NIAGroup/2020_Arduino_Pi_IOT_Project/README.md

# 2020_Arduino_Pi_IOT_Project 

This project utilizes a Flask webapp hosted on a Raspberry PI to control a cluster of Arduinos via bluetooth balancing a ping-pong ball on a flat beam. Each Arduino has a Pulse Width Modulation (PWM) stepper motor which is used to adjust the respective connected beams. The user enters values for the starting angle, proportion (kp), integral (ki), and derivative (kd) which are used in a PID control algorithm that dictates the behavior of the motors when attempting to place the ping-pong ball at the center of the beam.   



## Required Hardware

* Arduino & Supplies [LINK](https://www.amazon.com/ELEGOO-Project-Tutorial-Controller-Projects/dp/B01D8KOZF4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):  
    * Arduino Uno [alternate(s): arduino nano] 
    * Ultrasonic Sensor [alternate(s): IR Range Finder]
    * Stepper Motor & Driver
    * Jumper Wires (male-to-female & female-to-female)
* Raspberry Pi:
    * Pi 3 B+ & Power Supply [LINK](https://www.amazon.com/CanaKit-Raspberry-Power-Supply-Listed/dp/B07BC6WH7V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) [alternate(s): Pi 4, Pi Zero W]
    * 32GB Micro SD Card [LINK](https://www.amazon.com/SanDisk-Ultra-microSDXC-Memory-Adapter/dp/B073JWXGNT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) (16GB may be enough, but for future scaling up 32GB or greater would be best)
* Raspberry Pi Camera [LINK](https://www.amazon.com/Arducam-Raspberry-Camera-Module-Megapixel/dp/B083BHJZ16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)
* Ping Pong Ball [LINK](https://www.amazon.com/meizhouer-Colored-Entertainment-Tennis-Advertising/dp/B07JNCVVMF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)
* HC-05 Bluetooth Module [LINK](https://www.amazon.com/Wireless-Bluetooth-Transceiver-Module-Arduino/dp/B07T7ZZ3S5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)
* The Balance Beam 
>NOTE:: The balance beam will have to be hand crafted for now. When a tested design has been found/made it can be included in the list.  

## Prior Knowledge Needed/Googled

* Basic linux commands (i.e. cd, ls, mkdir, etc)
* Basic C/C++ understanding for arduino
* Basic circuit wiring understanding
* Intermediate Python 
* Basic HTML

## Expected Gained Knowledge  

* PWM - Pulse Width Modulation for Stepper Motor Control [EXPLAINED](https://www.youtube.com/watch?v=avrdDZD7qEQ)
* Bluetooth communication [ARDUINO & HC-05](https://www.youtube.com/watch?v=OhnxU8xALtg) [Raspberry PI](https://www.youtube.com/watch?v=F5-dV6ULeg8)
* Web Server Website/WebApp setup using apache2 [TUTORIAL](https://www.youtube.com/watch?v=dmBqzq3M5jQ)
* Front-End & Back-End Development
* PID - Proportional-Integral-Derivative Controller [EXPLAINED](https://www.youtube.com/watch?v=g7apd9a7Jxs)
