NIAGroup/2020_Arduino_Pi_IOT_Project/PID_controller_WebUI_roughdraft_00.PNG

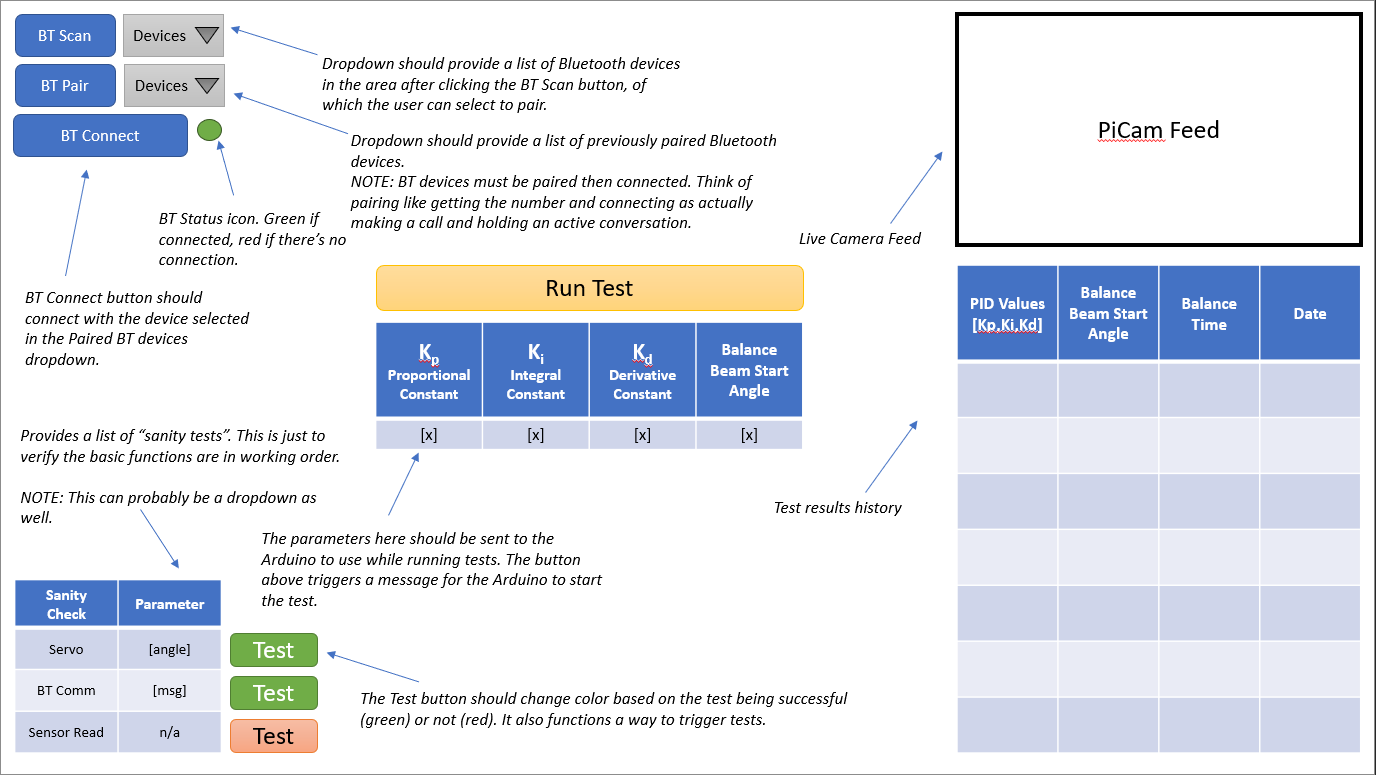
PID_controller_WebUI_roughdraft_00.PNG
