NIAGroup/2020_Arduino_Pi_IOT_Project/arduino_pid_controller/img/Servo_Wiring_Diagram.PNG

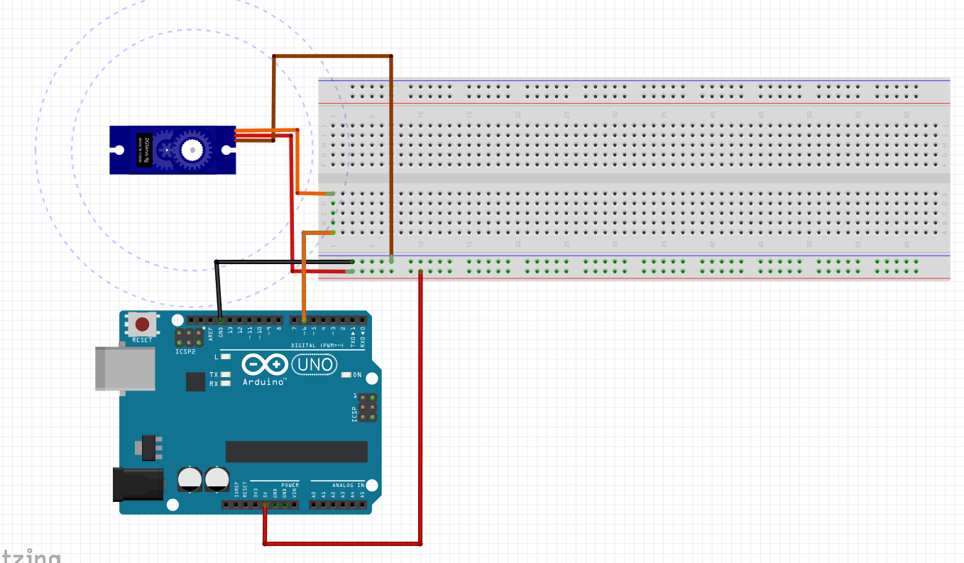
arduino_pid_controller/img/Servo_Wiring_Diagram.PNG
