NIAGroup/2020_Arduino_Pi_IOT_Project/arduino_pid_controller/img/UltrasonicSensor_Wiring_Diagram.PNG

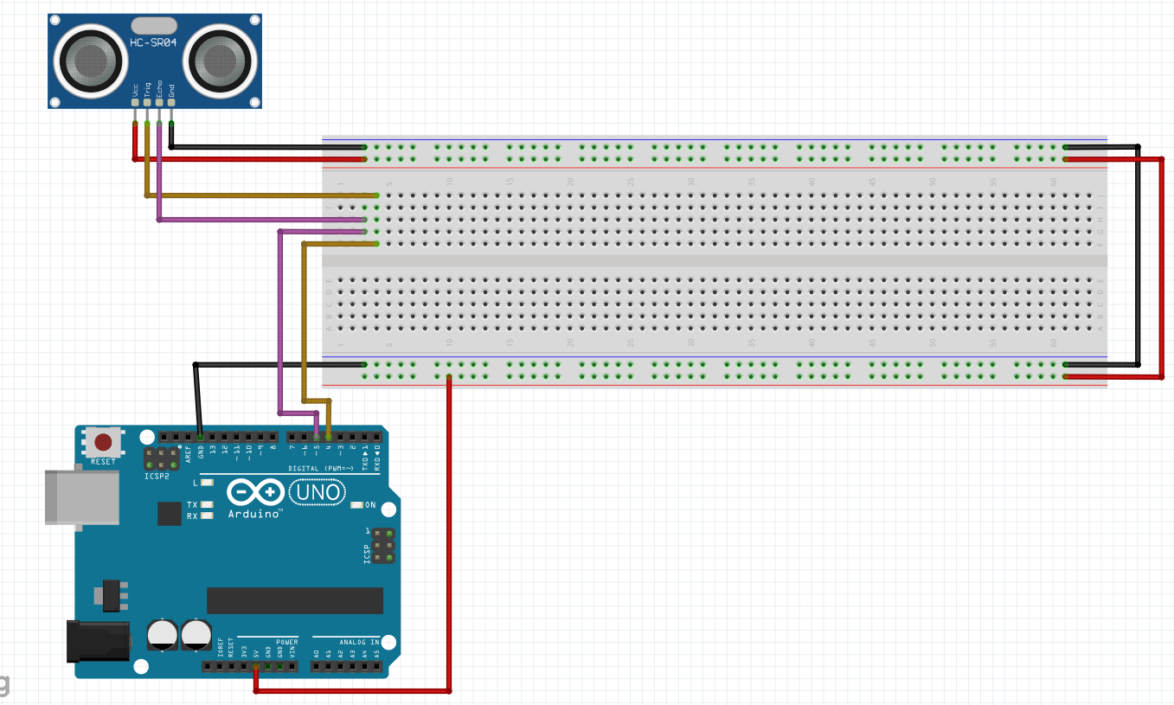
arduino_pid_controller/img/UltrasonicSensor_Wiring_Diagram.PNG
