NIAGroup/2020_Arduino_Pi_IOT_Project/arduino_pid_controller/code/btCommunication/BT_Communication_Standard.cpp

#include "BT_Communication_Standard.h"


BTComm_Standard::BTComm_Standard(){
 // default code
} 

FullBtMsg BTComm_Standard::Process_Request(byte pi_request[], byte length){
  FullBtMsg request;
  for(byte i = 0; i< length;i++){
   request.full_msg[i].full_byte = pi_request[i]; 
  }
  return request;
}

boolean BTComm_Standard::isSanityCheck(byte command_byte){
  byte upper_nibble = command_byte & 0b10000000;
  upper_nibble = upper_nibble >> 7;
  byte return_bit = 0;
  if (upper_nibble == 0){
    return_bit = false;
  }
  else{
    return_bit = true;
  }
  return return_bit;
}
