NIAGroup/2020_Arduino_Pi_IOT_Project/(commit log)

2020-07-29 Create ultrasonicSensor_example.ino
    Beginner's Example for sensor reading & PWM writing
2020-08-01 Create test_btScanForDevices.py
    added test to scan for bluetooth devices, both classic & ble devices.
    requires:
    python library - pybluez
    python library - gattlib
2020-08-05 Add files via upload
    added new wiring diagram examples for the HC-05 Bt Module & the Micro Servo
2020-08-05 Update ultrasonicSensor_example.ino
    editing pin assignment to make integration easier to follow.
2020-08-10 corrected navbar link error.
    [btCommunication_example.ino]
2020-08-31 Adding initial work to create a bluetooth device container for back-end work
2020-09-04 Message structures and device container classes constructed
2020-09-05 BT Ble device class 60% done and device list 70% done.
2020-09-08 new arduino test code and bt comm changes for testing [WIP]
2020-09-09 get_device api for obtaining a device by name.
2020-09-21 Added timer functions to original file
2020-09-23 import error fixed in app.py and devices.py. Additionally, displaying the new html code as the frontend.
2020-09-26 added sanity test for servo messages
2020-10-05 pairing script for non-ble devices
2020-10-06 bluetooth ble & non-ble send functions working and being received by the arduino successfully.
2020-10-06 send & receive working for ble & non-ble for both arduino & raspberry pi.
2020-10-06 fixed cached/old response error.
    [btCommunication.ino]
2020-10-11 Adding the ability to return a scanned device list name to a reactive list
2020-10-19 Initial back-end and js work for identifying selected devices and doing POST requests
2020-10-22 Cleaned up connection code with boarder color changes and back-end cleanup
2020-11-02 Adding read command for ble device
2020-11-16 Adding regular bluetooth device object
2020-11-24 minor tweaks for handling printing message payloads
2020-11-25 adding self._dev in ble device initalizer
2020-11-25 adjusted camera settings
2020-11-25 flipped camera view
2020-11-28 Adding pytests framework
2020-12-08 pulled to match branch and update PID controller example.
2020-12-09 PID controller function is working for (P) for the PID. Still testing
2020-12-09 corrected PID_D equation and testing w/ PID_P & PID_D values works
    [PIDcontroller_example.ino]
2020-12-28 Adding more unit testing for device class.
2021-01-04 Adding disconnect API in device classes and cleaning up app.py
2021-01-05 servo pin changed from pin 6 -> pin 5 & BLE enabled.
2021-01-05 added test condition for all 8 zero bytes as an option for both nonBle and Ble devices.
2021-01-06 sharpIR sensor example added as a reference. This uses the sharpIR library.
2021-01-06 updated sharpIR sensor instantiation to match the specific library version.
2021-01-08 adjusted example for basic sensor reading test.
2021-01-08 added functionality to eventually calculate upper and lower limits for the PID output.
2021-01-08 working PID controller example code with latest setup. Ready for testing.
2021-01-08 communication test code servo sanity check servo writing commented out. New ranges need to be created based on the new setup.
2021-01-08 added file for testing camera bug fixes and got latest files from the master branch.
2021-01-08 system delay by camera bug fixed.
2021-01-08 updated latest webapp w/ camera bug fix
2021-01-12 Updated database code to save connected devices
2021-01-14 Deleted resources/camera.py
2021-01-18 small tweaks for handling connected devices
2021-01-29 Initial work for PID read/write implementation.
2021-02-01 minor tweak to improve visibility on print
2021-02-03 syncing latest changes from master to current branch
2021-02-04 updated code to include error handling for invalid servo sanity check commands and a red LED error indicator.
    [BT_Communication_Standard.cpp, BT_Communication_Standard.h, btCommunication.ino]
2021-02-04 added custom PID controller library and call when the correct bt message is received. Error handling is still needed. [WIP]
    [PID_Controller.cpp, PID_Controller.h, btCommunication.ino]
2021-02-05 Changes to make the message structures and function tests aligned with arduino
2021-02-06 updated to test sending PID commands
2021-02-06 PID bluetooth request reading is functional
2021-02-09 latest changes to pid controller ready for validation.
2021-02-09 Adding changes to make it work with arduino arch
2021-02-10 includes changes to support returning completionTime & correct status byte assignment in response payload
    [btCommunication.ino]
2021-02-10 changed ord->int to fix PID command bug
2021-02-10 added default for the PID command fields.
2021-02-10 switched ord to int for nonBle devices
2021-02-10 updated to remove over use of print lines and certain variable assignments in the PID code.
2021-02-10 removed value assignments of non-constant variables & removed test print lines from PID control method.
